markuswettstein/digipedal/hardware/exports/BOM_digipedal_2026-01-13.csv

ID | Name | Designator | Footprint | Quantity | Manufacturer Part | Manufacturer | Supplier | Supplier Part | Price
1 | 1625854-3 | GND,A2,B2,W2,9V,RA1,RA2,RC1,RC2,RC3,W1,B1,LED | TESTPOINT-SMD_L1.6-W0.8 | 13 | 1625854-3 | TE Connectivity(泰科电子) | LCSC | C5379041 | 0.184
2 | 35RAPC4BH3 | CN1,CN2 | AUDIO-TH_35RAPC4BH3 | 2 | 35RAPC4BH3 | Switchcraft | LCSC | C4991662 | 3.393
3 | MCP45HV31T-103E/MQ | U2,U3 | VQFN-20_L5.0-W5.0-P0.65-TL-EP3.3 | 2 | MCP45HV31T-103E/MQ | MICROCHIP(美国微芯) | LCSC | C623611 | 1.045
4 | 1uF | C1 | C0603 | 1 | CL10A105KB8NNNC | SAMSUNG(三星) | LCSC | C15849 | 0.005
5 | 470pF | C2 | C0603 | 1 | 0603B471K500NT | FH(风华) | LCSC | C1620 | 0.003
6 | 10uF | C3,C5,C9 | C0603 | 3 | CL10A106MA8NRNC | SAMSUNG(三星) | LCSC | C96446 | 0.017
7 | 100nF | C4,C6,C10 | C0603 | 3 | CC0603KRX7R9BB104 | YAGEO(国巨) | LCSC | C14663 | 0.002
8 | 100nF | C7,C8 | C0603 | 2 | CC0603ZRY5V7BB104 | YAGEO(国巨) | LCSC | C519445 | 0.004
9 | 2.54 Header | CON1,CON2 | 1X5X2.54-PIN-HEADER-M-TH-V | 2
10 | 1N4148WS T4 | D1,D2 | SOD-323_L1.8-W1.3-LS2.5-RD | 2 | 1N4148WS | CJ(江苏长电/长晶) | LCSC | C2128 | 0.009
11 | MMBT3904-C20526 | Q1,Q3,Q2 | SOT-23-3_L2.9-W1.3-P1.90-LS2.4-BR | 3 | MMBT3904(RANGE:100-300) | CJ(江苏长电/长晶) | LCSC | C20526 | 0.009
12 | 4.7kΩ | R1,R2 | R0603 | 2 | 0603WAF4701T5E | UNI-ROYAL(厚声) | LCSC | C23162 | 0.001
13 | 2.2kΩ | R3,R5,R7,R11 | R0603 | 4 | 0603WAF2201T5E | UNI-ROYAL(厚声) | LCSC | C4190 | 0.001
14 | 100kΩ | R4,R9,R12 | R0603 | 3 | 0603WAF1003T5E | UNI-ROYAL(厚声) | LCSC | C25803 | 0.001
15 | 220Ω | R6,R8,R10 | R0603 | 3 | 0603WAJ0221T5E | UNI-ROYAL(厚声) | LCSC | C1226 | 0.001
16 | MIC5219-5.0YM5-TR | U1 | SOT-23-5_L3.0-W1.7-P0.95-LS2.8-TL | 1 | MIC5219-5.0YM5-TR | MICROCHIP(美国微芯) | LCSC | C144182 | 0.747
17 | PC817B-FEL-S | U5 | SOP-4_L6.5-W4.6-P2.54-LS10.2-TL | 1 | PC817B-FEL-S | DDF(鼎德丰) | LCSC | C50229497 | 0.04
18 | G6K-2G-Y-TR DC5 | U4 | RELAY-SMD_G6K-2G-Y-1 | 1 | G6K-2G-Y-TR DC5 | OMRON(欧姆龙) | LCSC | C2153087 | 1.359
