markuswettstein/digipedal/hardware/exports/PCB_PCB_digipedal_2026-01-13.pdf

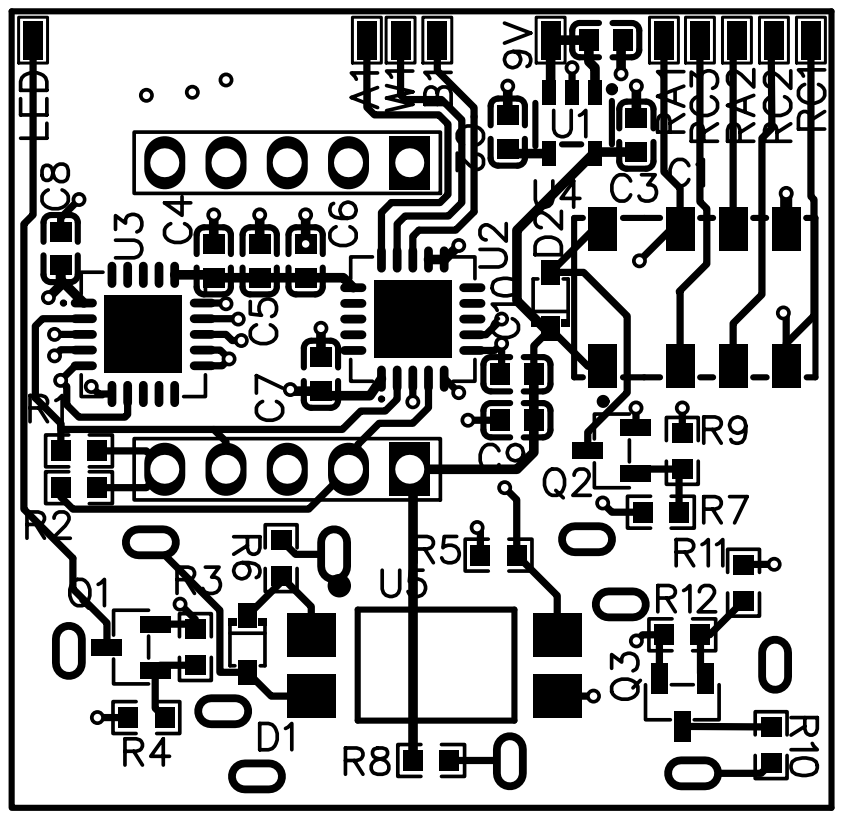
[picture p1: page 1]
