markuswettstein/digipedal/hardware/exports/Schematic_digipedal_2026-01-13.pdf

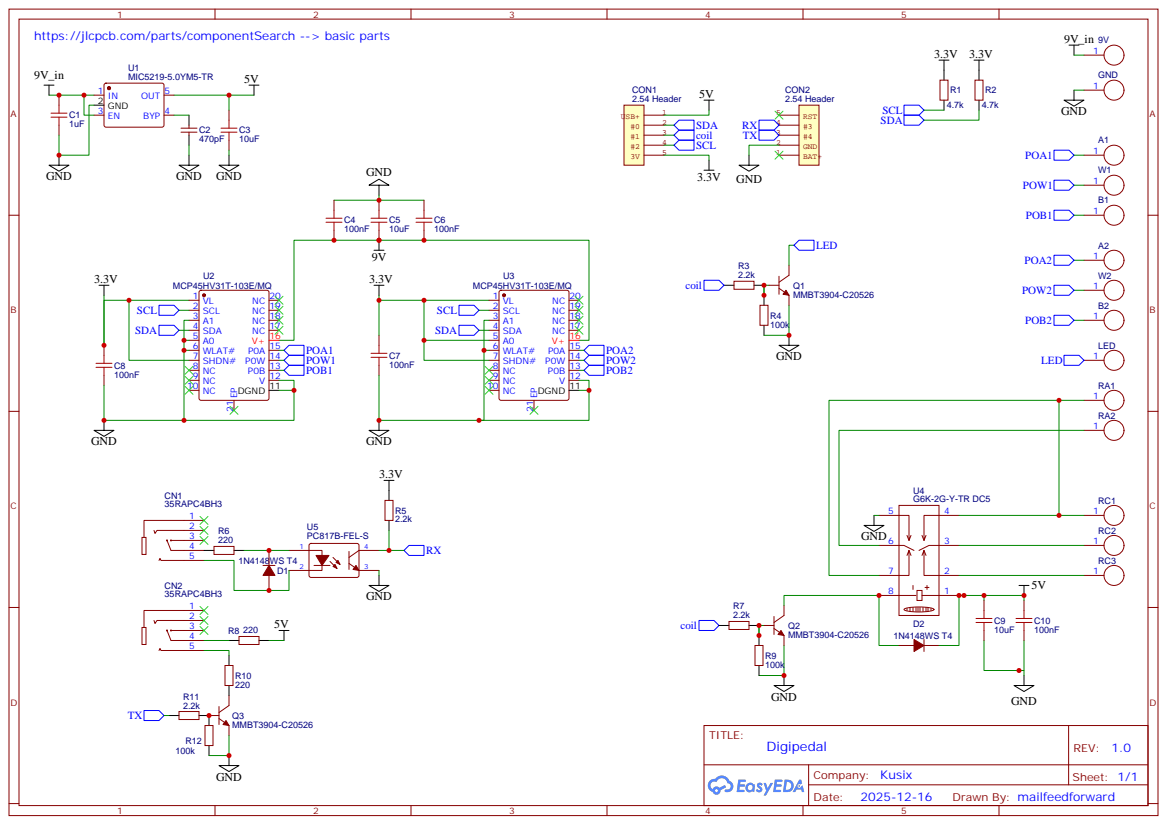
[picture p2: page 1]

https://jlcpcb.com/parts/componentSearch --> basic parts
