markuswettstein/digipedal/(list of files, drawings)

Other design files:
hardware/easyeda/PCB_PCB_digipedal_2026-01-13.json
hardware/easyeda/SCH_digipedal_2026-01-13.json
