markuswettstein/digipedal/firmware/digipedal/src/status_led.h

#pragma once
#include <stdint.h>

namespace status_led {

void init();
void off();

// Very short flash to indicate activity (MIDI, I2C, etc.)
void activity();

// Solid colors for states
void ok();
void error();

// Call each loop iteration; turns off the activity flash after its hold time
void tick();

} // namespace status_led
