markuswettstein/digipedal/(commit log)

2026-01-13 Add digipedal sketch and arduino-cli configuration
2026-01-13 Add Makefile for arduino-cli build/upload
2026-01-13 Add EasyEDA hardware design files
    [BOM_digipedal_2026-01-13.csv, PCB_PCB_digipedal_2026-01-13.json, SCH_digipedal_2026-01-13.json]
2026-01-13 Add bring-up module and formalize pin-map
2026-01-13 Add standalone LED self-test in bring-up
2026-04-21 Wire MIDI parser into main loop; add relay and midi_handler modules
    - Fix digipot wiper range: MCP45HV31T is 7-bit (max 128, not 255)
    - Add relay module with 50 ms debounce
    - Add midi_handler module: Config struct with channel + CC mapping,
    dispatches CC to digipot and relay
    - Symlink src_core/midi_parser into firmware/src so Arduino build
    shares the same file as the unit tests
    - Force -std=gnu++17 in arduino-cli build for std::optional support
    - Replace delay(5000) with non-blocking 1 s USB Serial wait
    - Check SHDN bit on digipot read; signal error LED on failure
    - Consolidate activity LED decay into status_led::tick()
    [bringup.cpp, digipot.cpp, digipot.h, midi_handler.cpp, midi_handler.h, pins.h]
